alwynallan/twocents/README.md

# twocents
$.02 Hardware RNG for IoT. RNGoT?

Inspired by discussions on http://www.metzdowd.com/mailman/listinfo/cryptography and having a NodeMCU clone handy I put together a capacitor and resistor on two free IO pins.

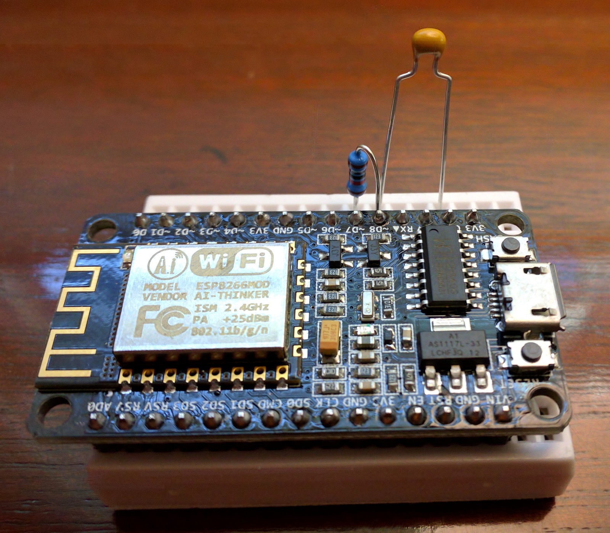
[picture p1: twocents_breadboard.jpg]
Breadboard


The idea is that the capacitor is charged and discharged through the resistor and the voltage is sensed as either a low or high
on a digital input. The circuit has a time constant of 1ms and the chip can measure time with a resolution of 1/80us so the times
to charge and discharge should contain some entropy.

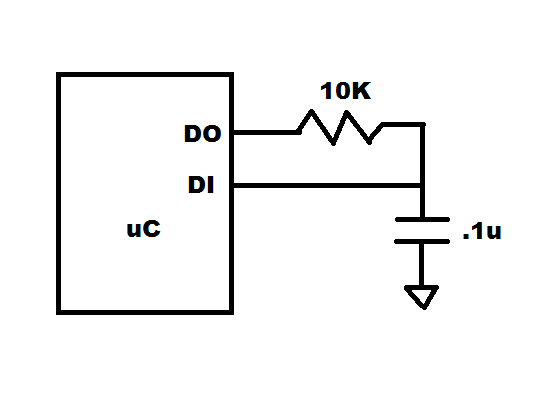
[picture p2: twocents_schematic.png]
Schematic


It appears that the circuit charges slowly with a hard-to-predict number of test loops, but discharges quickly in 1 or 2 test loops. That is because the storage of the result happens after the discharge, using some time, and there is some overshoot on the low side. A delay can be introduced after the charging to even things out, but it doesn't increase entropy rate. By checking the time each cycle we gather the entropy.

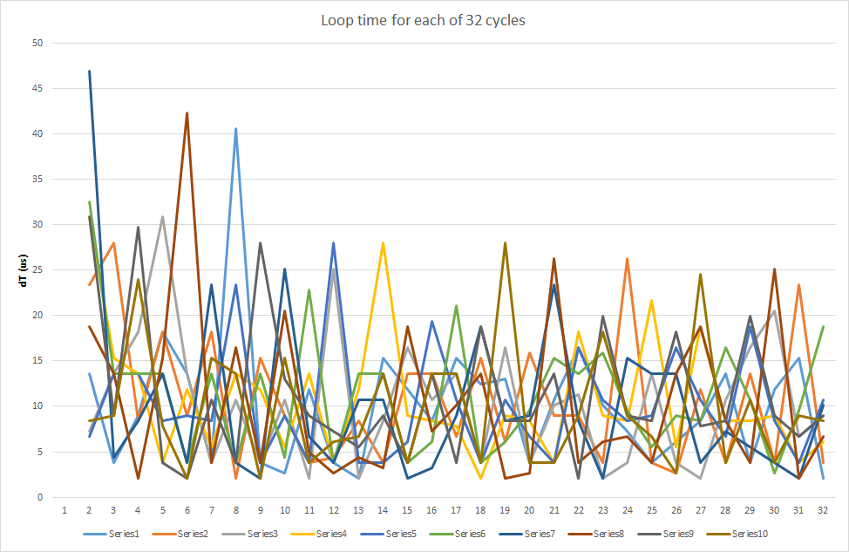
[picture p3: twocents_times.png]
Timing


There's no need to subtract the previous time to get the loop time, because the entopy is in the time measurement regardless. A routine was written that XOR's 32 processor times into a 32-bit register with a different rotation each time. The **res** variable is static so it holds the last value between calls, preserving entropy if we're not adding enough. More than 32 loops would be safer, but testing estimates that there are ~4 bits/loop as it is.

```c
uint32_t twocents(void){
  static uint32_t res=0U; // only initializes once
  for(register int i=0; i<32; i++){
    digitalWrite(D7, HIGH);
    while(digitalRead(D8) != HIGH);
    digitalWrite(D7, LOW);
    while(digitalRead(D8) != LOW);
    res ^= rotateRight(ESP.getCycleCount(),i);
  }
  return res;
}
```

The routine runs in about 700us 6/7 of the time and twice that 1/7 of the time. On average 40kbps can be expected. A sample of the resulting data looks full-entropy.

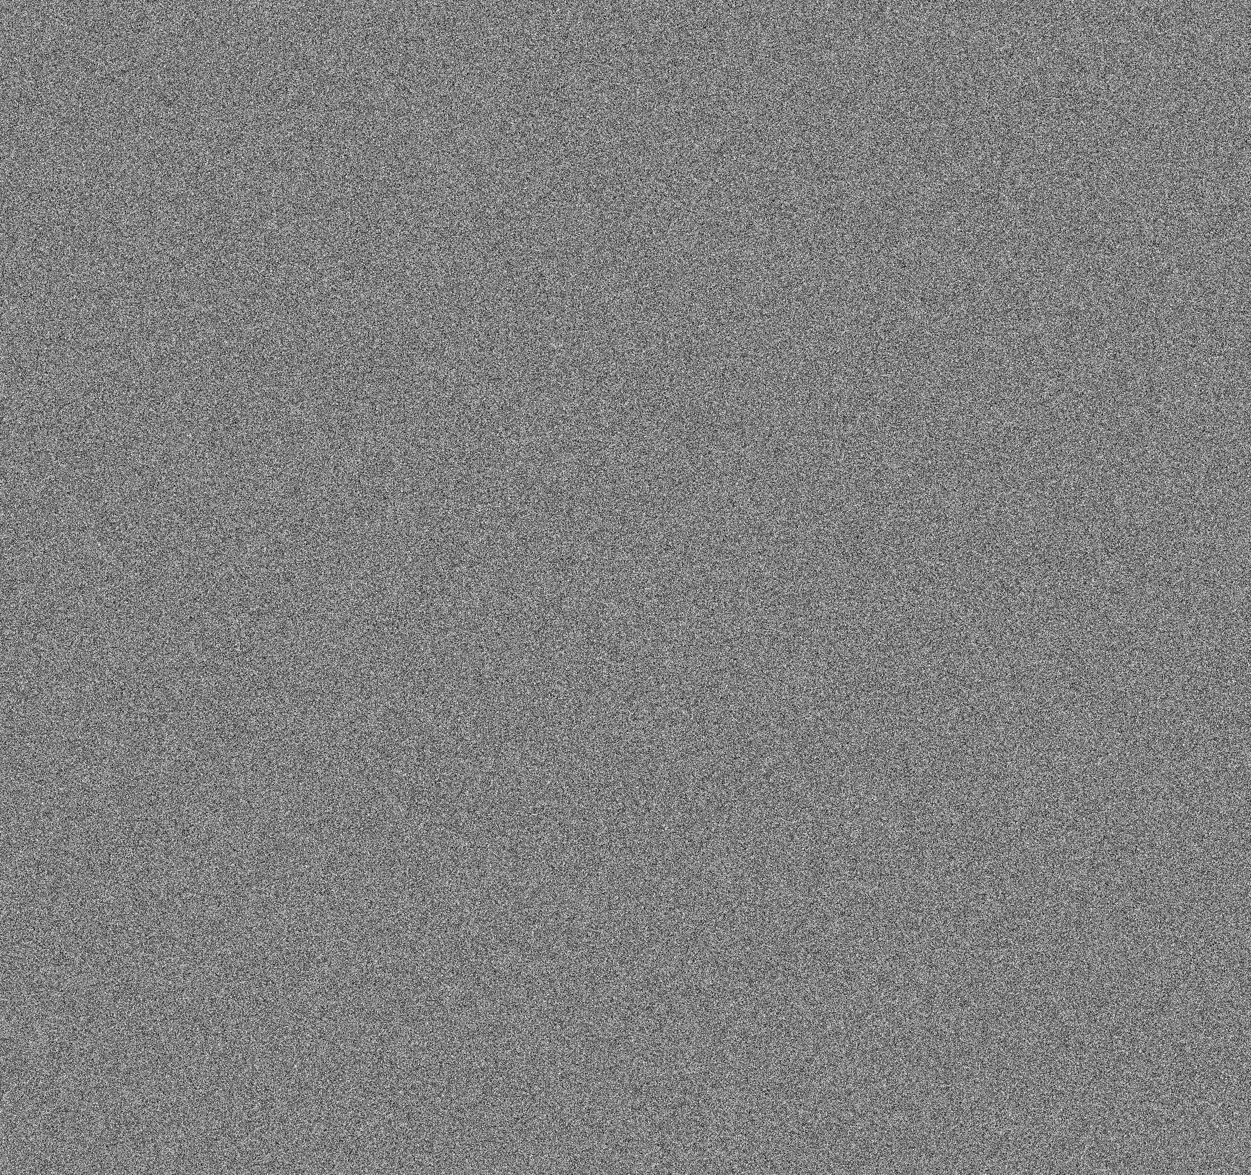
[picture p4: twocents.bin.png]
Bits


Comments are welcome as "issues" above. Remember this is a $.02 RNG for a $2 computer. The type of data it's intended to protect
is over-the-air software updates for a thermostat, when nefarious hackers want to create a slave army of bitcoin miners. Also,
we can buy a capacitor and a resistor for under $.01 on AliExpress.com in 1000 quantities, with free shipping! It's the same
place I got the [clone](http://www.aliexpress.com/item/NodeMcu-Lua-WIFI-development-board-based-on-the-ESP8266-Internet-of-things/32339203041.html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,searchweb201644_4_10014_10001_10002_10005_301_10006_10003_10004_62,searchweb201560_5,searchweb1451318400_6151,searchweb1451318411_6450&btsid=21fbf57c-19aa-467e-b179-a6d97a313032).
