alwynallan/twocents/(commit log)

2016-01-21 Added schematic
2016-01-21 Added sample data
2016-01-21 Name change. The previous name had an association that was unintended.
    [twocents_times.xlsx]
2016-01-21 More name change
    [twocents_times.xlsx]
2016-01-21 Count loops not processor cycles in setup(). Analysed the loop counts on new spreadsheet tab.
    [twocents_times.xlsx]
2016-01-22 Updated spreadsheet
    [twocents_times.xlsx]
2016-01-22 Code cleanup register variables
    New tabs in spreadsheet for more data
    [twocents_times.xlsx]
2016-01-22 Spreadsheet update
    [twocents_times.xlsx]
2016-01-23 Added servedata branch for isolation experiment
    [twocents_delayornot.xlsx]
